yhxln/core-et-erbium/doc/qspi.md

# QSPI Datasheet

\Begin{multicols}{2}

The Quad SPI is an improved version of SPI with multiple IO lines i.e. QSPI supports dual as well as Quad IO lines support. (Better performance compared to legacy SPI). The QSPI also comes with the Execute in Place option which avoids copying the code to the On chip memory and executing. The core can directly read from flash and execute. i.e. the QSPI flash chips can act like normal RAM to the core.

The QSPI implementation also has programmable address size, data size, dummy cycle, instruction size, etc. The IO lines as well as the QSPI clock are all software configurable.

## Features

* Supports Single/dual/Quad SPI mode.
* Single / Double Data rate support.
* Supports 3 modes
    * Indirect mode (All operations are performed using QSPI registers).
    * Automatic status polling mode (flash status register is periodically read and interrupt is generated on flag setting).
    * Memory mapped mode (XiP mode): flash memory is mapped into device address space and seen as internal memory.
* Programmable for Single SPI (Legacy SPI), Dual IO mode & Quad IO mode.
* Programmable widths for Address, data, dummy cycles, instruction, alternative mode, etc.
* Common 32 byte FIFO is shared across both transmit & receive.
* Status register & interrupt enable registers.
* Programmable flash size.
* Mode 0 and mode 3 support.

\End{multicols}

## Ports

| Port Name | Direction | Description |
| --- | --- | --- |
| CLK | O | Serial clock for QSPI communication. |
| CS | O | Chip select signal for QSPI applications. |
| IO[3:0] | IO | Quad data lines. Output when configured to send commands and acts as input when configured to receive data (response). |

## QSPI registers

The original register IP sizes are variable for the Shakti use cases, and the data duplicates it across for the access size. Although logically 32-bit or less on the IP side, they are accessible as 64-bit values on the system bus.
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
