yhxln/core-et-erbium/(commit log)

2026-06-19 Restore top-level testbench makefiles
    Restore the ELF and Verilator makefile entrypoints used by the top-level testbench flow.
2026-06-22 Restore upstream license headers on third-party-derived files
    These five files are derivatives of external projects whose original
    copyright notices had been stripped. Restore the upstream notices
    (required by MIT and BSD-3-Clause), add an SPDX identifier and an
    Ainekko modifications line, and record the Shakti/IIT Madras component
    in LICENSE.
    Gnarly Grey LLC (2017), MIT:
    ip/hyperbus/testbench/Hyperbus/sim/hbc_io.v
    ip/hyperbus/testbench/tb_top.v
    Shakti / IIT Madras (2018), BSD-3-Clause (via anirudsr06/MemVer):
    ip/qspi/bsv/qspi.bsv
    ip/uart/bsv/uart_axi.bsv
    ip/uart/bsv/uart_cfg_regs.bsv
    LICENSE: add Shakti/IIT Madras BSD-3-Clause subcomponent entry.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
